parate/Kossel-SmoothiePi-mount/pics/bottom view.JPG

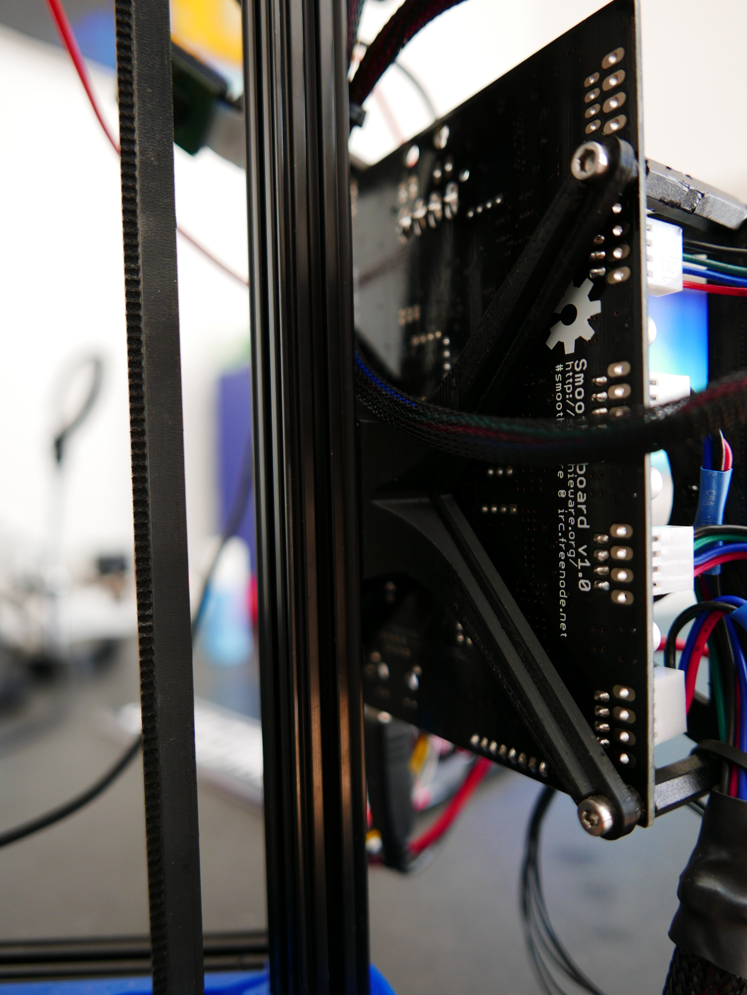
pics/bottom view.JPG
