parate/Kossel-SmoothiePi-mount/pics/view from top.JPG

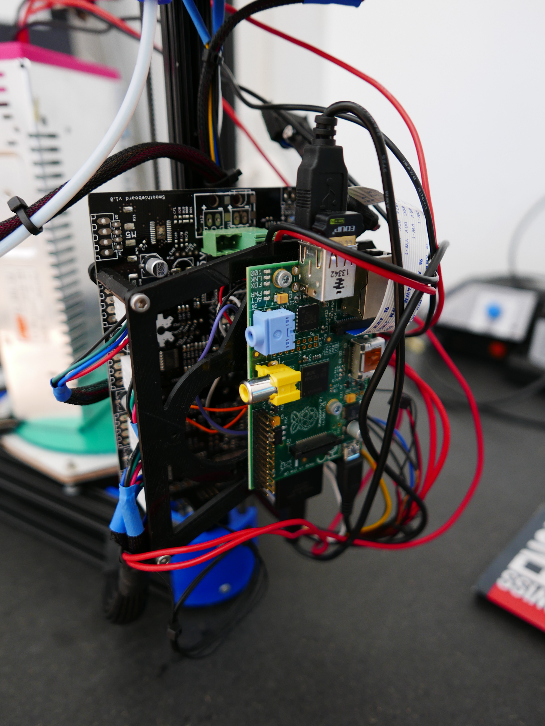
pics/view from top.JPG
