parate/Kossel-SmoothiePi-mount/pics/camera arm 2.JPG

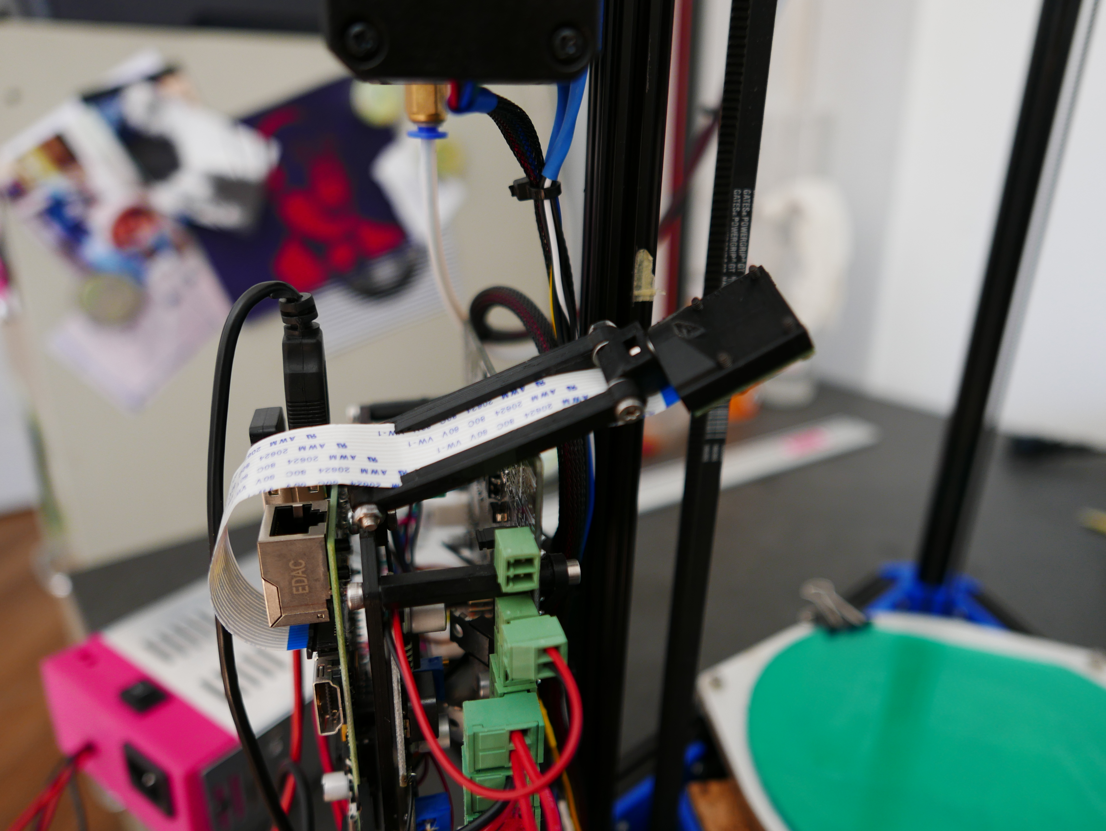
pics/camera arm 2.JPG
