parate/Kossel-SmoothiePi-mount/step/cam-arm-plate-connector.stp

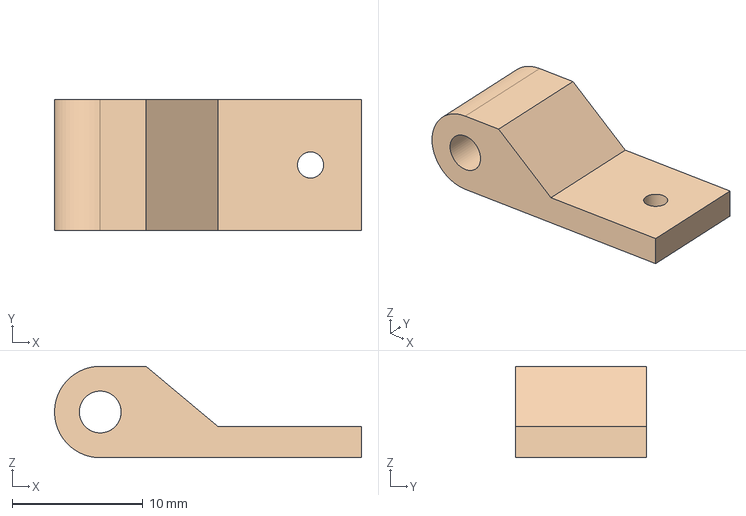
[picture p4: CAD file, 2015-08-27]
step/cam-arm-plate-connector.stp
23.5 x 10.0 x 7.00 mm
