parate/Kossel-SmoothiePi-mount/stl/spacer.stl

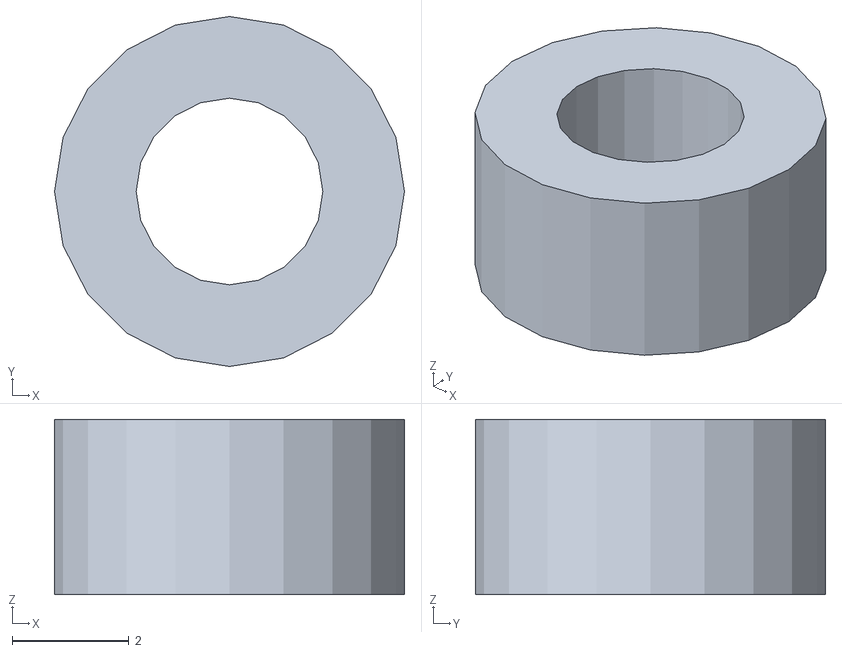
[picture p5: CAD file, 2015-03-06]
stl/spacer.stl
6.00 x 6.00 x 3.00
