parate/Kossel-SmoothiePi-mount/step/cam-arm-rotator.stp

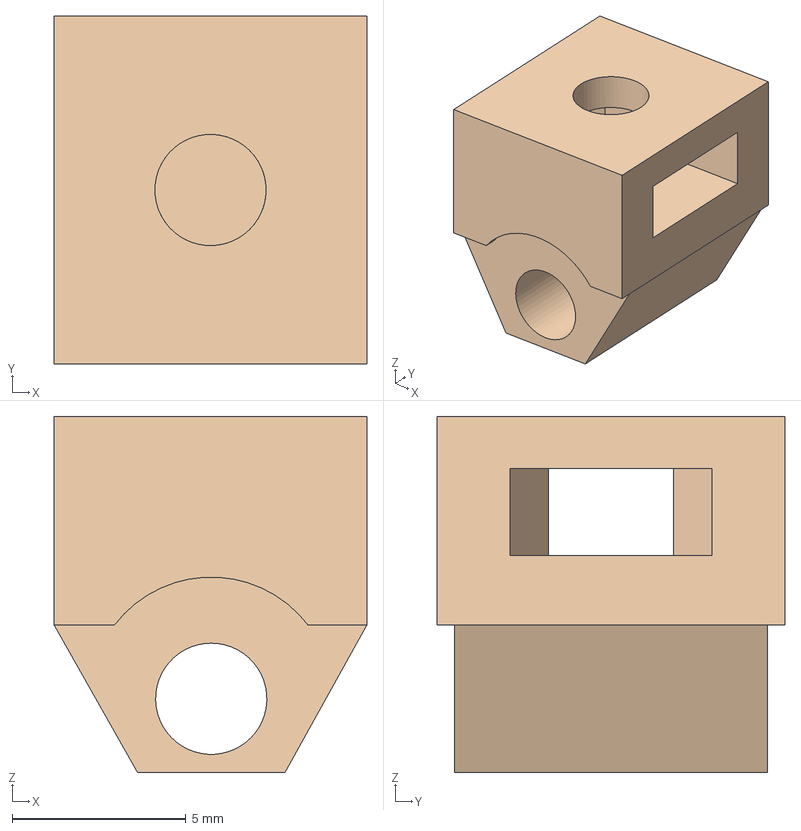
[picture p6: CAD file, 2015-08-27]
step/cam-arm-rotator.stp
9.00 x 10.0 x 10.2 mm
