parate/Kossel-SmoothiePi-mount/step/cam-arm-extension-right.stp

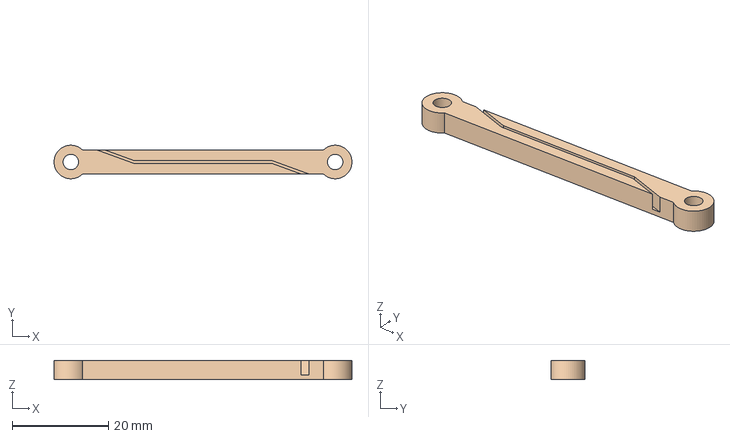
[picture p7: CAD file, 2015-08-27]
step/cam-arm-extension-right.stp
62.0 x 7.00 x 4.00 mm
