parate/Kossel-SmoothiePi-mount/step/smoothie-mount.stp

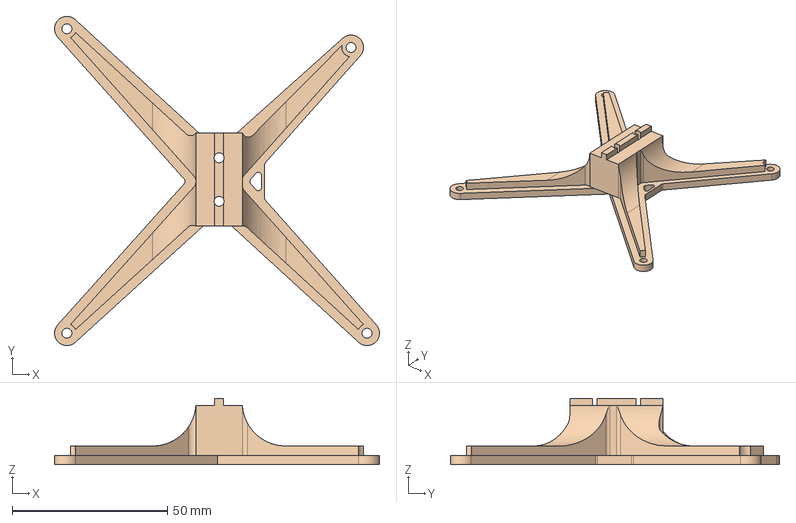
[picture p8: CAD file, 2015-08-27]
step/smoothie-mount.stp
104.6 x 106.0 x 21.4 mm
