parate/Kossel-SmoothiePi-mount/step/cam-arm-camera-fixture.stp

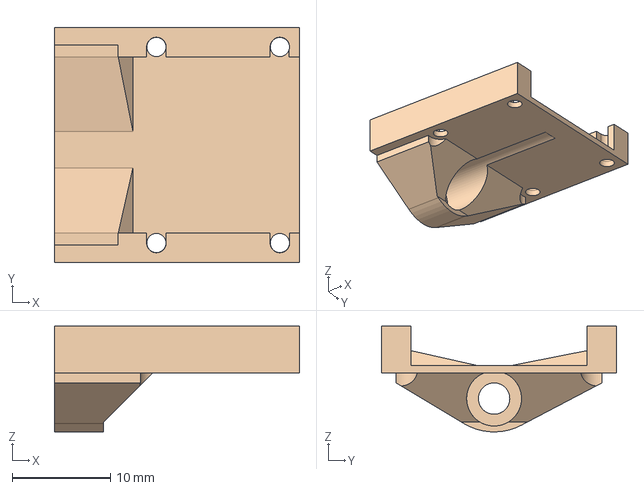
[picture p9: CAD file, 2015-08-27]
step/cam-arm-camera-fixture.stp
25.0 x 24.0 x 10.8 mm
