parate/Kossel-SmoothiePi-mount/step/pi-mount.stp

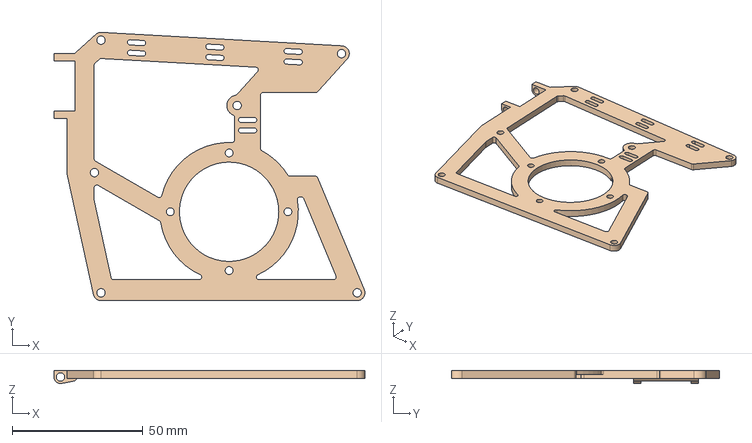
[picture p10: CAD file, 2015-08-27]
step/pi-mount.stp
119.0 x 102.6 x 5.00 mm
