parate/Kossel-SmoothiePi-mount/(list of files, cad)

Other CAD files:
step/plate-pi-cam-mount-spacers.stp
step/cam-arm-extension-left.stp
stl/cam-arm-camera-fixture.stl
stl/cam-arm-extension-left.stl
stl/cam-arm-extension-right.stl
stl/cam-arm-plate-connector.stl
stl/cam-arm-rotator.stl
stl/pi-mount.stl
stl/plate-pi-cam-mount-spacers.stl
stl/smoothie-mount.stl
