parate/Kossel-SmoothiePi-mount/(commit log)

2015-03-06 Added stls
    Added all needed stl's
    [cam-arm-camera-fixture.stl, cam-arm-extension-left.stl, cam-arm-extension-right.stl, cam-arm-plate-connector.stl, cam-arm-rotator.stl, pi-mount.stl, plate-pi-cam-mount-spacers.stl, smoothie-mount.stl]
2015-03-08 Fixed screw holes, other minor aestethical fixes.
    [smoothie-mount.stl]
2015-08-27 Updated files
    [cam-arm-camera-fixture.stp, cam-arm-extension-left.stp, cam-arm-extension-right.stp, cam-arm-plate-connector.stp, cam-arm-rotator.stp, pi-mount.stp, plate-pi-cam-mount-spacers.stp, smoothie-mount.stp]
